CopperPilot/smartwatch/hardware/README.md

# Rugged 49 mm Smartwatch — Hardware & Electrical Design Documentation

Generated from `rea/spec.yaml` by `rea-hardware` (JLCPCB 2-layer stackup, 34.0 x 40.0 mm board outline at origin with 6.0 mm corner radius, and 4x M1.6 mounting holes), and completed with verified LCSC components, symbols, footprints, and 3D models.

## 1. Power Tree, Protection & Quiescent Current Budget

- **Rear Magnetic Pogo Charging Input (`J3`, `YZT0755-20028-02025-01`, LCSC `C5280828`, plus `TP9` on `/VCHG_RAW`):**
  - **Contact Current Rating:** Rated `2.0 A` per contact (`2 contacts` = `VCHG_RAW` and `GND`). Peak charging current is `147 mA` (`0.07x` rated current, `>13x` safety margin).
  - **ESD, Negative-Transient Clamping, Overcurrent PPTC Fuse, Reverse-Polarity Blocking, Overvoltage Protection & Reverse-Current Blocking:**
    - `D2` (`ESDLC12VLB`, YANGJIE 12 V bidirectional ESD/surge protection TVS diode in DFN1006-2L, LCSC `C20168169`, `V_RWM = 12 V`, `V_BR = 14.0 V` min, `V_C = 20 V` at `I_PP = 6 A` `< 24 V`, connected between `/VCHG_RAW` and `/GND`) provides IEC 61000-4-2 +/-30 kV bidirectional ESD and surge clamping. Because `V_C <= 20 V`, negative ESD or reverse-polarity transients on `J3.1` are clamped to `>= -20 V` (well inside upstream P-MOSFET `Q7` `AO3401A` `V_DS(max) = -30 V` when `Q7` is off and `C24` holds `VCHG_IN` at `0 V`), while positive transients are clamped to `<= +20 V` so `U6.1` (`OVP_FB`, via `R27 = 35.7 kOhm` / `R28 = 10.0 kOhm`) never exceeds `20 V * 10.0 / 45.7 = 4.38 V` (strictly below `U6`'s `+6.0 V` FB Absolute Maximum Rating). `R26` (`100 kOhm`) bleeds `VCHG_RAW` to `0.00 V` when unmated so exterior gold-plated contacts never carry DC bias against skin.
    - `F2` (`0603L050SLYR`, Littelfuse `0.50 A` hold / `1.00 A` trip ultra-low-resistance `0.14 Ohm` typ / `0.35 Ohm` max 0603 PPTC resettable fuse, LCSC `C207014`) sits in series with `J3.1` between `/VCHG_RAW` (`F2.1`) and `/VCHG_FUSED` (`F2.2`), tripping at `<= 1.00 A` (`>3.4x` margin above the `147 mA` normal charge current and `< 52 mV` voltage drop at `147 mA`) to protect `D1` (`PMEG2010EA,115`, `1.0 A` max) and `U8` (`TPS2553DBVR`, `1.5 A` max).
    - `Q7` (`AO3401A`, P-MOSFET in SOT-23, LCSC `C15127`, `V_DS(max) = -30 V`, `V_GS(max) = +/-12 V`, `R_DS(on) ~ 50 mOhm`, drain `Q7.3` on `/VCHG_FUSED`, source `Q7.2` on `/VCHG_IN`, gate `Q7.1` on `/VCHG_Q7_G`) blocks reverse-polarity connections on `J3` before they can reach `U6`'s `-0.3 V` substrate limit. `Q7`'s gate is pulled to `GND` by `R38 = 100 kOhm` (`0402WGF1003TCE`, LCSC `C25741`, providing full `V_GS = -5 V` gate drive during normal 5 V charging and dissipating `< 4 mW` at 20 V clamping) and clamped across Source-to-Gate by `D11` (`PESD5V0S1BL`, LCSC `C2912556`).
    - `C24` (`GRM188R6YA106MA73D`, 10 uF 35 V X5R 0603, LCSC `C194427`) provides high-voltage input decoupling on `/VCHG_IN` per `ETA7014S2G` datasheet recommendations.
    - `U6` (`ETA7014S2G`, 36 V input overvoltage protection load switch in SOT-23-6, LCSC `C7465500`, `R_ON = 35 mOhm` typ) sits on `/VCHG_IN` (`U6.4`, with `VCC`/`EN` `U6.5`/`U6.2` filtered via `R29 = 1 kOhm` `0402WGF1001TCE`, LCSC `C11702` + `C23 = 1 uF` 50 V X5R 0402 `GRM155R61H105KE05D`, LCSC `C1518208`) and outputs `/VCHG_PROT` (`U6.3`, bypassed by `C26 = 1 uF` 25 V X5R 0402 `CL05A105KA5NQNC`, LCSC `C52923`). Precision `0.1%` thin-film divider `R27 = 35.7 kOhm` (`ERA-2AEB3572X`, LCSC `C2075580`) and `R28 = 10.0 kOhm` (`RT0402BRD0710KL`, LCSC `C190095`) on `OVP_FB` (`U6.1`, `V_FB = 1.26 V +/- 0.05 V` = `1.21 V` min to `1.31 V` max) programs the overvoltage cutoff threshold to `V_OVP(typ) = 1.26 V * (35.7 + 10.0) / 10.0 = 5.758 V`, with worst-case minimum `V_OVP(min) = 1.21 V * (35.7 * 0.999 + 10.0 * 1.001) / (10.0 * 1.001) = 5.521 V > 5.500 V` (guaranteeing normal `4.75–5.50 V` USB `vSafe5V` input never trips OVP) and worst-case maximum `V_OVP(max) = 1.31 V * (35.7 * 1.001 + 10.0 * 0.999) / (10.0 * 0.999) = 5.996 V < 6.000 V` (strictly below the `6.5 V` recommended operating and `7.0 V` Absolute Maximum Rating of downstream `U8` `TPS2553DBVR`, and below the `6.0 V` recommended operating and `7.0 V` Absolute Maximum Rating of `U2` `MCP73832T-2ACI/OT`), while `U6`'s internal soft-start controls capacitive hot-plug inrush into `C26` (`1 uF`) and `C11` (`4.7 uF`).
    - `U8` (`TPS2553DBVR`, TI `2.5–6.5 V` recommended operating / `7.0 V` Absolute Maximum Rating, `1.5 A`, `85 mOhm` current-limited power-distribution switch with active reverse input-output voltage blocking in SOT-23-6, LCSC `C55266`) sits downstream of `U6` between `/VCHG_PROT` (`IN` Pin 1, tied to `EN` Pin 3) and `/VBUS` (`OUT` Pin 6, decoupled by `C11 = 4.7 uF`), providing `504 mV` of recommended-operating margin (`6.500 V` vs `V_OVP(max) = 5.996 V`) and `1.004 V` of absolute-maximum margin (`7.000 V` vs `5.996 V`) across `U6`'s entire OVP tolerance window, active reverse-voltage/reverse-current blocking (`I_rev = 0.01 uA` typ / `1.0 uA` max when `V_OUT > V_IN + 135 mV`) so no battery voltage back-feeds onto `/VCHG_PROT` or exposed pogo contact `J3.1`, and `2 us` fast electronic current limiting programmed via `R41 = 35.7 kOhm` `0.1%` (`ERA-2AEB3572X`, LCSC `C2075580`) on `ILIM` (Pin 5, net `/VCHG_ILIM`) to `I_OS(min) = 667 mA`, `I_OS(typ) = 729 mA`, `I_OS(max) = 799 mA < 1.0 A`.
    - Factory charging test pad `TP9` (`B.Cu`) is connected to `/VCHG_RAW` upstream of `F2`, `Q7`, `U6`, and `U8` so factory fixture supplies pass through full overcurrent, reverse-polarity, OVP, soft-start, and RCB protection.
- **Battery Connector (`J2`, `SM02B-SRSS-TB(LF)(SN)`, LCSC `C160402`), 12 V PPTC Fuse (`F1`) & UVLO-Wakeable Reverse-Battery Protection (`Q2` + `Q6` + `Q8` + `D10` + `D13` + `D12` + `R34..R37`):**
  - Connector entry `/VBAT_IN` (`J2.1`) is protected directly at the connector by `D9` (`PESD5V0S1BL`, 5 V bidirectional TVS diode, LCSC `C2912556`) and series resettable PPTC fuse `F1` (`ASMD0603SL100-12V`, 12 V, `1.0 A` hold / `2.0 A` trip ultra-low-resistance `45 mOhm` typ 0603 PPTC fuse, LCSC `C48783158`).
  - High-side reverse-polarity P-MOSFET `Q2` (`AO3401A`, LCSC `C15127`, drain on `/VBAT_FUSED`, source on `/VBAT`) has its gate (`/VBAT_Q2_G`) pulled to its source (`/VBAT`) via `R34 = 1 MOhm` (`0402WGF1004TCE`, LCSC `C26083`) and pulled to `/GND` by N-MOSFET `Q6` (`BSS138K`, LCSC `C5224263`, `V_GS(th) = 0.4–1.0 V`), whose gate (`/VBAT_Q2_EN`) is driven from `/VBAT_FUSED` via `R35 = 100 kOhm` (`0402WGF1003TCE`, LCSC `C25741`) and from `/VBUS` via ultra-low-leakage diode `D10` (`1N4148WS`, LCSC `C2128`, net `/VBAT_WAKE`) in series with `R36 = 100 kOhm` (`0402WGF1003TCE`, LCSC `C25741`), while a second blocking diode `D13` (`1N4148WS`, LCSC `C2128`, net `/VBAT_SENSE_WAKE`) separately feeds `R37 = 100 kOhm` (`0402WGF1003TCE`, LCSC `C25741`), NPN BJT `Q8` (`MMBT3904`, LCSC `C909754`), and Schottky diode `D12` (`1N5819WS`, LCSC `C191023`) for reverse-polarity lockout without bleeding battery current (`0 uA` parasitic path from `VBAT_FUSED` through `R35 -> R36` when unplugged, preserving full `V_GS(Q6) = 3.0–4.2 V` gate drive).
- **1S LiPo Linear Charger (`U2`, `MCP73832T-2ACI/OT`, LCSC `C38066`) & Digital VBUS Detection (`R24`/`R25`):**
  - `R10 = 6.8 kOhm` (`C25917`) programs `I_REG = 1000 V / 6.8 kOhm = 147.1 mA` (`0.67C` for the `220 mAh` `LP352022` pouch cell).
  - Open-drain charge status output `U2.1` (`STAT`) is pulled up to `+3V3` via `R23` (`10 kOhm`) and routed to `U1.14` (`IO10`, `CHG_STAT`).
  - `/VBUS` presence is sensed digitally on `U1.15` (`GPIO11` / `RTC_GPIO11`) via `R24 = 68 kOhm` (`0402WGF6802TCE`, `C36871`) and `R25 = 100 kOhm` (`0402WGF1003TCE`, `C25741`), yielding `2.77–3.15 V > V_IH(min) = 2.475 V`.
- **Load-Sharing Power Path (`Q1` `AO3401A` + `D1` `PMEG2010EA,115` + `R13` `1 kOhm`), Buck-Boost +3V3 Regulation (`U4` `TPS63031DSKR` + `L1` `1.5 uH`) & LDO +1V8 Regulation (`U5` `ME6211C18M5G-N`):**
  - Low-leakage MEGA Schottky `D1` (`PMEG2010EA,115`, LCSC `C193668`) and P-MOSFET `Q1` (`AO3401A`, LCSC `C15127`, with `1 kOhm` gate pulldown `R13`) provide automatic single-diode-drop power path switching onto `/VSYS` (`10 uF` `C7`).
  - `U4` (`TPS63031DSKR`, LCSC `C15516`, `1.8–5.5 V` input, `3.3 V` fixed output buck-boost converter with `1.5 uH` inductor `L1` `WPN201610U1R5MT`, LCSC `C97017`, `EN` and `PS/SYNC` `U4.6`/`U4.7` tied to `VINA`/`VIN` on `/VSYS`, dedicated `100 nF` `C28` on `VINA` `U4.8`, `100 nF` `C3` adjacent to `U4.1` `VOUT`, and two parallel `10 uF` 25 V X5R 0603 bulk capacitors `C8` + `C27` `CL10A106MA8NRNC` `C96446` providing `>= 12 uF` DC-biased effective output capacitance) maintains regulated `+3V3` across the full `3.0–4.2 V` 1S LiPo discharge range, and `U5` (`ME6211C18M5G-N`, `C236671`, `1.8 V / 300 mA` LDO, `CE` tied to `VSYS`) supplies continuous `+1V8` to `U3` (`MAX30102EFD+T` `VDD`).
  - **Local IC Decoupling on `/+3V3`:** `C1` (`100 nF` 0402, `C1525`, at `8.29, 3.85 mm`) and `C13` (`10 uF` 0603, `C96446`, at `8.38, 5.85 mm`) are functionally grouped in the schematic and placed within `1.54–1.97 mm` of `U1` pin 3 (`3V3` pad at `10.02, 4.75 mm`) on `F.Cu` with dedicated local `/GND` stitching vias (`7.20, 3.85 mm` and `7.20, 6.625 mm`); `C4` (`100 nF` 0402, `C1525`, at `30.10, 23.45 mm`) is functionally grouped and placed immediately adjacent (`0.77 mm`) to `U9` (`TPS3421EGDRYR` at `31.25, 23.80 mm`) pin 4 (`VCC` pad at `30.86, 23.30 mm`) with a dedicated `/GND` stitching via at `(29.65, 23.65 mm)`.

## 2. Display Backlight Constant-Current Driver, UI Protection & Sensor Level Shifting

- **Display FPC (`J1`, `FPC-05FB-12PH20`, LCSC `C2856829`) & Constant-Current Backlight Driver (`U7`, `CAT4002ASD-GT3`, LCSC `C890382`):**
  - 12-pin 0.5 mm pitch double-sided contact FPC connector `J1` mates with the 12-pin 1.9-inch `170x320` `ST7789V2` IPS TFT module (`ZJY190S0800TG01` / `GMT169-01`), with `100 kOhm` pull-ups `R39`/`R40` on `LCD_CS`/`LCD_RES`, separate `LEDA` (Pin 3, tied to `/VSYS` with `1 uF` bypass `C25`), and `LEDK` (Pin 2, `/LCD_LEDK`) regulated by `U7` (`CAT4002ASD-GT3`, `R14 = 3.6 kOhm` for `41.7 mA` total sink current, dimmed via 1-wire EZDim pulse bursts on `U7.1` from `U1.25`).
- **Sealed-Enclosure Long-Press Push-Button Hardware Reset Supervisor (`U9`, `TPS3421EGDRYR`, LCSC `C2067262`):**
  - `U9` (`TPS3421EGDRYR`, `250 nA` push-button reset controller in SON-6, `TS` tied to `/GND` for `7.5 s` setup delay) monitors `SW2` (`/BTN_SIDE_SW`) and asserts a `400 ms` active-low hardware reset pulse on `/MCU_EN` (`U1.45`) when `SW2` is held for `>= 7.5 s`.
- **Rotary Encoder (`SW1`, `EC05E1220203`) & Tactile Button (`SW2`/`SW3`, `SKRTLAE010`) Contact-Current & ESD Protection:**
  - Switch terminals have `10 kOhm` pull-ups `R3..R6` to `+3V3` and 5 V bidirectional ESD TVS diodes `D5..D8` (`PESD5V0S1BL`, LCSC `C2912556`), followed by `10 kOhm` series current-limiting/ESD-isolation resistors `R30..R33` feeding `10 nF` encoder filter capacitors `C17..C18` (`<= 0.33 mA` contact discharge current) and `100 nF` tactile switch debounce capacitors `C19..C20`.
- **1.8 V <-> 3.3 V Fast-Mode I2C & Interrupt Level Translation (`Q3..Q5`, `BSS138K`, LCSC `C5224263`):**
  - `Q3`, `Q4`, and `Q5` use low-capacitance sub-1V-threshold small-signal N-MOSFETs (`BSS138K`, `C_iss = 25 pF`, `C_oss = 9.7 pF`, `C_rss = 2.2 pF`, `V_GS(th) = 0.4–1.0 V`) with gates on `+1V8`, `1.8 kOhm` pull-ups `R7, R8` (to `+1V8`) and `R20, R21` (to `+3V3`, `0402WGF1801TCE`, LCSC `C25871`) on `I2C_SCL` and `I2C_SDA` (yielding RC rise time `t_r ~ 70 ns << 300 ns` 400 kHz Fast-Mode limit while keeping total low-level sink current `I_OL = 2.83 mA < 3.0 mA`), and `10 kOhm` pull-ups `R9` (to `+1V8`) and `R22` (to `+3V3`, `0402WGF1002TCE`, LCSC `C25744`) on open-drain interrupt `HR_INT`.

## 3. Datasheet Derating Summary (Capacitors, MOSFETs, Connectors & Bootloader Path)

- **Capacitor Voltage Ratings (`>= 1.5x` Maximum Net Voltage):**
  - `/OVP_VCC` (`<= 20 V` surge clamped by `D2`): `C23` (`1 uF`, `GRM155R61H105KE05D`, `C1518208`) rated `50 V` (`2.50x` surge / `10.0x` nominal 5 V).
  - `/VCHG_IN` (`<= 20 V` surge clamped by `D2`): `C24` (`10 uF`, `GRM188R6YA106MA73D`, `C194427`) rated `35 V` (`1.75x` surge / `7.0x` nominal 5 V).
  - `/VCHG_PROT` (`<= 5.996 V` `U6` OVP cutoff): `C26` (`1 uF`, `CL05A105KA5NQNC`, `C52923`) rated `25 V` (`4.17x`).
  - `/VBUS` (`<= 5.996 V` OVP cutoff): `C11` (`4.7 uF`, `CL10A475KO8NNNC`, `C19666`) rated `16 V` (`2.67x`).
  - `/VBAT` (`<= 4.20 V` LiPo charge voltage): `C12` (`4.7 uF`, `CL10A475KO8NNNC`, `C19666`) rated `16 V` (`3.81x`).
  - `/VSYS` (`<= 5.8 V` OVP / `4.6 V` nominal): `C7, C14` (`10 uF`, `25 V`, `C96446`), `C25` (`1 uF`, `25 V`, `C52923`), and `C6, C28` (`100 nF`, `16 V`, `C1525`) provide `>= 2.76x` margin.
  - `/+3V3`, `/+1V8`, `/VBAT_ADC`, `/MCU_EN`, UI & RTC crystal nets (`<= 3.3 V`): `C1..C5, C15, C19, C20` (`16 V`), `C8, C9, C10, C13, C27` (`25 V`), and `C17, C18, C21, C22` (`50 V`) provide `>= 4.85x` margin.
- **MOSFET `|V_GS|` and `|V_DS|` Ratings:**
  - `Q7` (`AO3401A`, `V_DS(max) = -30 V`, `V_GS(max) = +/-12 V`): upstream `D2` (`ESDLC12VLB`, `V_C = 20 V` at `6 A`) clamps `|V_DS| <= 20 V < 30 V`, and `D11` (`PESD5V0S1BL` across Source-to-Gate) clamps `|V_GS| <= 7.0 V < 12 V`.
  - `Q1, Q2` (`AO3401A`, `V_DS(max) = -30 V`, `V_GS(max) = +/-12 V`): operate on `/VBUS` (`<= 6.0 V`) and `/VBAT` (`<= 4.2 V`), keeping `|V_GS| <= 6.0 V < 12 V` and `|V_DS| <= 6.0 V < 30 V`.
  - `Q3..Q6` (`BSS138K`, `V_DS(max) = 60 V`, `V_GS(max) = +/-20 V`): operate on `1.8 V`, `3.3 V`, and `4.2 V` nets (`|V_GS| <= 4.2 V < 20 V`).
- **Connector Contact Current Ratings & Ground Returns:**
  - `J3` (`YZT0755-20028-02025-01`, 2-pin pogo): rated `2.0 A`/contact vs `147 mA` charge current (`13.6x` margin).
  - `J2` (`SM02B-SRSS-TB(LF)(SN)`, 2-pin JST-SH): rated `1.0 A`/contact vs `<= 365 mA` peak battery current (`2.74x` margin).
  - `J1` (`FPC-05FB-12PH20`, 12-pin 0.5 mm FPC): rated `0.5 A`/contact vs `41.7 mA` on `LEDA`/`LEDK` and `< 15 mA` on `+3V3` `VDD`, with 4 distributed `GND` return pins (`Pins 1, 5, 6, 12`) flanking the backlight and 4-wire SPI signals.
- **MCU Programming & Bootloader Conditions (`U1`, `ESP32-S3-MINI-1-N8`):**
  - Native USB Serial/JTAG (`GPIO19` `USB_D-` / `GPIO20` `USB_D+` via `22 Ohm` `R15`/`R16` and `PESD5V0U1BL` `D3`/`D4`) and `UART0` (`U0TXD`/`U0RXD`), `MCU_EN` (`R1 = 10 kOhm` pull-up to `+3V3`, `C10 = 1 uF` delay, `TP6`), `GPIO0` (`BOOT_IO0`, `R2 = 10 kOhm` pull-up to `+3V3`, `TP5`), `+3V3` (`TP8`), `VCHG_RAW` (`TP9`), and `GND` (`TP7`) are exposed on `B.Cu` pogo test pads `TP1..TP9` (`GPIO45` and `GPIO46` strapping pins left unconnected at default internal pull-down).
