CopperPilot/smartwatch/reviews/judge.md

# Independent judge

A separate agent compares the renders of the finished design with the reference photos, without seeing the design files or the other agents' notes.

**Overall 8/10** · form 8 · features 9 · requirements 9 (pass mark 7).

## Differences from the reference

- The transverse band lug channels are cut into flat vertical top and bottom end walls rather than blending into angled underside lug chamfers as on the reference case.
- The active window of the off-the-shelf 1.9-inch 170x320 rectangular TFT panel leaves a slightly wider lateral black mask border under the cover glass than the reference custom squircle display.
- The rear sensor dome incorporates a dedicated 2-pin magnetic pogo contact cutout next to the central optical sensor window as specified for the magnetic pogo charging cable, and the left speaker grille uses an 8-hole two-row array adjacent to the action button rather than the reference 10-hole three-row pattern.

## Requirements

| Id | Verdict | Note |
|---|---|---|
| R1 | met | The 44.0 x 49.0 x 14.4 mm rounded-rectangular case combines an 11.4 mm lower titanium-style side wall and right-side crown guard with a stepped 3.0 mm domed rear sensor cover matching the reference silhouette. |
| R2 | met | Top and bottom 32.0 mm transverse T-slot lug channels in case_body accept the connector bars of the 49 mm corrugated tubular fluoroelastomer strap_band sliding sideways along +X. |
| R3 | met | Actuator and internal renders confirm crown_cap presses coaxially onto the horizontal shaft of rotary encoder SW1 (EC05E1220203) through a sealed side bore while snap-retained side_button and action_button plungers directly contact edge tactile switches SW2 and SW3 (SKRTLAE010). |
| R4 | met | Purchased 1.9-inch 170x320 ST7789V2 IPS TFT module (ZJY190S0800TG01) sits beneath a flat 40.4 x 45.4 x 1.0 mm cover glass with a printed black border bonded by 0.2 mm 3M 9495LE PSA onto a 1.5 mm case ledge inside a 1.75 mm raised bezel rim. |
| R5 | met | Bottom-mounted MAX30102EFD+T PPG optical sensor (U3) aligns concentrically behind the 12.0 mm circular optical sensor_window in the domed rear cover. |
| R6 | met | Port and rear renders confirm the 2-pin gold-plated magnetic spring pogo receptacle J3 (YZT0755-20028-02025-01) on the bottom of the PCB faces directly outward through the rear_cover stadium cutout with no extra side ports. |

## Features

| Id | Verdict | Note |
|---|---|---|
| F1 | ok | Flat cover glass with printed black perimeter border sits flush inside the thin 1.75 mm raised metal bezel rim over the 1.9-inch display window. |
| F2 | ok | Knurled rotary crown cap with orange accent ring sits in the upper right-side guard protrusion and mates coaxially onto the horizontal shaft of rotary encoder SW1. |
| F3 | ok | Pill-shaped right side button sits below the crown in the right-side guard housing and its internal plunger directly engages side tactile switch SW2. |
| F4 | ok | Flush pill-shaped orange action button sits on the left case wall next to the speaker grille and its internal plunger directly engages side tactile switch SW3. |
| F5 | ok | Circular 12.0 mm dark optical sensor window is centered in the domed rear cover directly over bottom-mounted PPG sensor U3. |
| F6 | ok | Both circular gold-plated pogo charging contacts of receptacle J3 face directly outward through the stadium cutout on the rear dome. |
