CopperPilot/smartwatch/reviews/review-main.md

# Design review: Main board

Datasheet-level review of the schematic and layout by CopperPilot's independent review agent (`validate`). Severity: **P0** must be fixed before fabrication, **P1** should be fixed, **P2** worth a look.

Result: **0 P0**, **0 P1**, **0 P2**.

No findings.
