CopperPilot/smartwatch/reference/README.md

# Reference

What the CopperPilot agents were given: the prompt in [prompt.md](prompt.md) and the photos below.

Reference photos of a commercial product, used here only for comparison. All rights belong to their owners; this project is not affiliated with or endorsed by the product's maker.

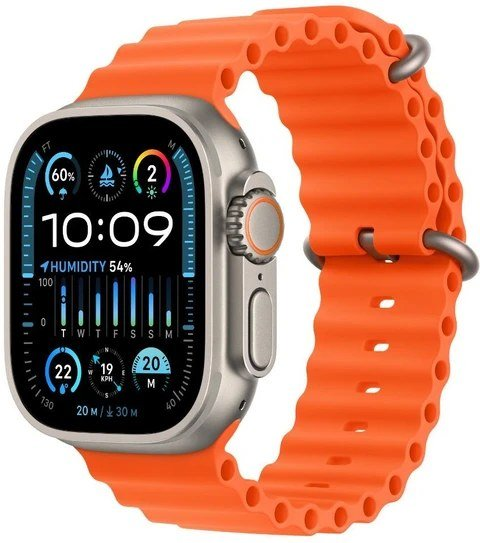
[picture p15: reference/photos/front.jpg]
front

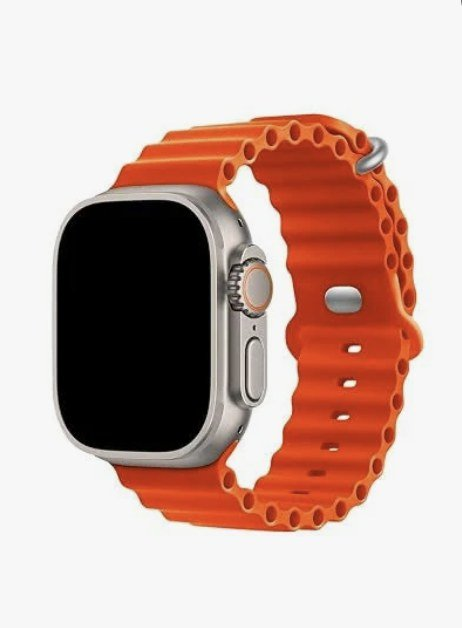
[picture p16: reference/photos/front_side.jpg]
front_side

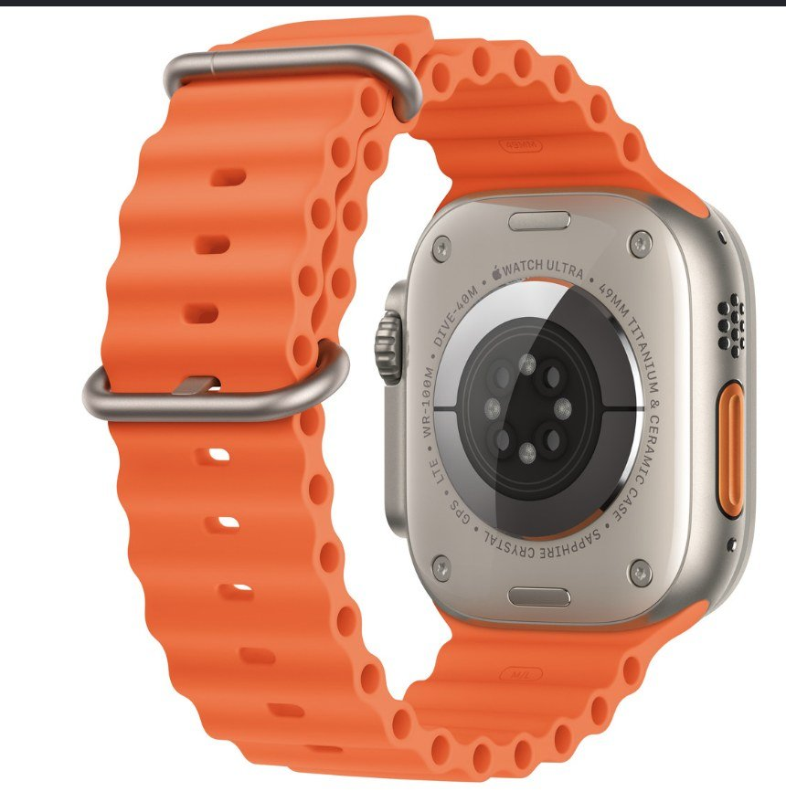
[picture p17: reference/photos/rear.jpg]
rear
