CopperPilot/smartwatch/docs/images/thumbnail.gif

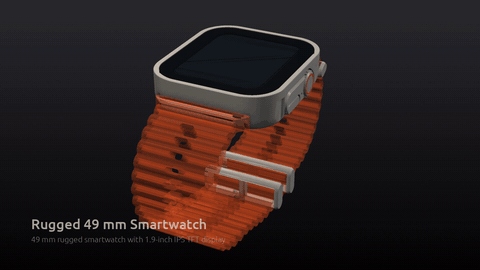
docs/images/thumbnail.gif
