CopperPilot/smartwatch/fab/rugged-smartwatch-bom.csv

Comment | Designator | Footprint | LCSC Part #
100nF | C1,C2,C3,C4,C5,C6,C15,C19,C20,C28 | C_0402_1005Metric | C1525
1uF | C9,C10,C25,C26 | C_0402_1005Metric | C52923
4.7uF | C11,C12,C16 | C_0603_1608Metric | C19666
10uF | C7,C8,C13,C14,C27 | C_0603_1608Metric | C96446
10nF | C17,C18 | C_0402_1005Metric | C60133
20pF | C21,C22 | C_0402_1005Metric | C1554
1uF | C23 | C_0402_1005Metric | C1518208
10uF | C24 | C_0603_1608Metric | C194427
PMEG2010EA,115 | D1 | SOD-323_L1.8-W1.3-LS2.5-RD | C193668
1N4148WS | D10,D13 | SOD-323_L1.8-W1.3-LS2.5-RD | C2128
PESD5V0S1BL | D5,D6,D7,D8,D9,D11 | DFN1006-2L-BI-1 | C2912556
1N5819WS | D12 | SOD-323_L1.8-W1.3-LS2.5-RD | C191023
ESDLC12VLB | D2 | DFN1006-2L-BI | C20168169
PESD5V0U1BL | D3,D4 | SOD-882_L1.0-W0.6-BI-1 | C2827663
ASMD0603SL100-12V | F1 | F0603 | C48783158
0603L050SLYR | F2 | F0603 | C207014
FPC-05FB-12PH20 | J1 | FPC-SMD_12P-P0.50_XUNPU_FPC-05FB-12PH20 | C2856829
SM02B-SRSS-TB(LF)(SN) | J2 | CONN-SMD_2P-P1.00_SM02B-SRSS-TB-LF-SN | C160402
YZT0755-20028-02025-01 | J3 | CONN-SMD_YZT0755-20028-02025-01 | C5280828
1.5uH | L1 | IND-SMD_L2.0-W1.6 | C97017
AO3401A | Q1,Q2,Q7 | SOT-23_L2.9-W1.3-P1.90-LS2.4-BR | C15127
BSS138K | Q3,Q4,Q5,Q6 | SOT-23-3_L2.9-W1.3-P1.90-LS2.4-BR | C5224263
MMBT3904 | Q8 | SOT-23-3_L2.9-W1.3-P1.90-LS2.4-BR | C909754
10k | R1,R2,R3,R4,R5,R6,R9,R22,R23,R30,R31,R32,R33 | R_0402_1005Metric | C25744
6.8k | R10 | R_0402_1005Metric | C25917
1M | R11,R12,R34 | R_0402_1005Metric | C26083
1k | R13,R29 | R_0402_1005Metric | C11702
3.6k | R14 | R_0402_1005Metric | C25891
22R | R15,R16 | R_0402_1005Metric | C25092
100k | R17,R25,R26,R35,R36,R37,R38,R39,R40 | R_0402_1005Metric | C25741
1.8k | R7,R8,R20,R21 | R_0402_1005Metric | C25871
68k | R24 | R_0402_1005Metric | C36871
35.7k | R27,R41 | R_0402_1005Metric | C2075580
10k | R28 | R_0402_1005Metric | C190095
EC05E1220203 | SW1 | SW-SMD_EC05E1220203 | C390930
SKRTLAE010 | SW2,SW3 | KEY-SMD_SKRTLAE010 | C110293
ESP32-S3-MINI-1-N8 | U1 | BULETM-SMD_ESP32-S3-MINI-1-N8 | C2913206
MCP73832T-2ACI/OT | U2 | SOT-23-5_L3.0-W1.7-P0.95-LS2.8-BL | C38066
MAX30102EFD+T | U3 | OESIP-14_L5.6-W3.3-P0.80-TL | C6454833
TPS63031DSKR | U4 | SON-10_L2.5-W2.5-P0.50-TL-EP | C15516
ME6211C18M5G-N | U5 | SOT-23-5_L3.0-W1.7-P0.95-LS2.8-BR | C236671
ETA7014S2G | U6 | SOT-23-6_L2.9-W1.6-P0.95-LS2.8-BL | C7465500
CAT4002ASD-GT3 | U7 | SC-70-6_L2.0-W1.3-P0.65-LS2.1-BR | C890382
TPS2553DBVR | U8 | SOT-23-6_L2.9-W1.6-P0.95-LS2.8-BR | C55266
TPS3421EGDRYR | U9 | SON-6_L1.5-W1.0-P0.50-BL | C2067262
32.768kHz | Y1 | FC-135R_L3.2-W1.5 | C32346
