CopperPilot/smartwatch/case/out/sensor_window_decor.stl

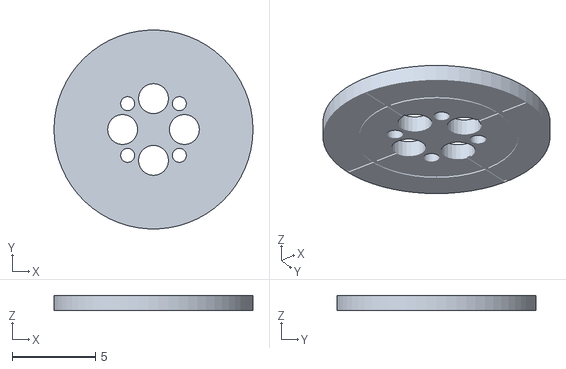
[picture p19: CAD file, 2026-11-04]
case/out/sensor_window_decor.stl
11.9 x 11.9 x 0.88
