CopperPilot/smartwatch/fab/mech/case_body.step

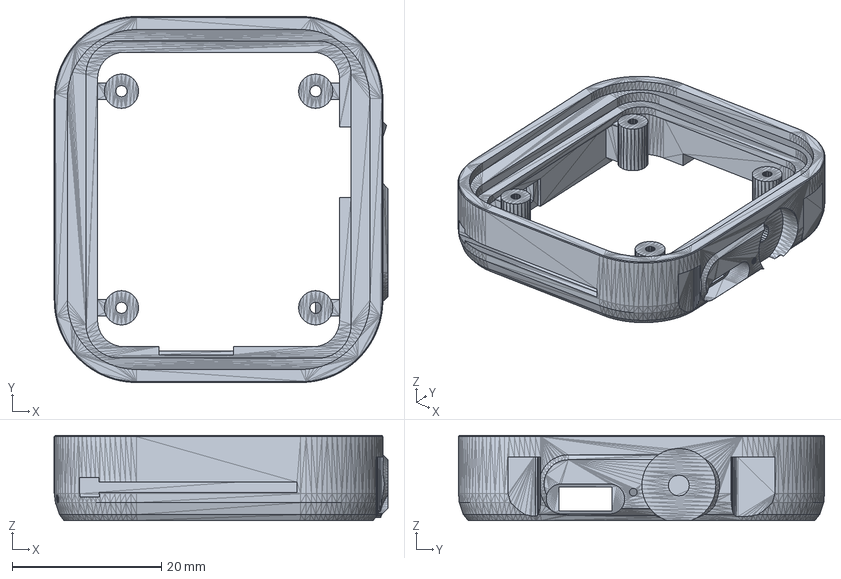
[picture p20: CAD file, 2026-11-04]
fab/mech/case_body.step
44.7 x 49.0 x 11.4 mm
