CopperPilot/smartwatch/fab/rugged-smartwatch.step

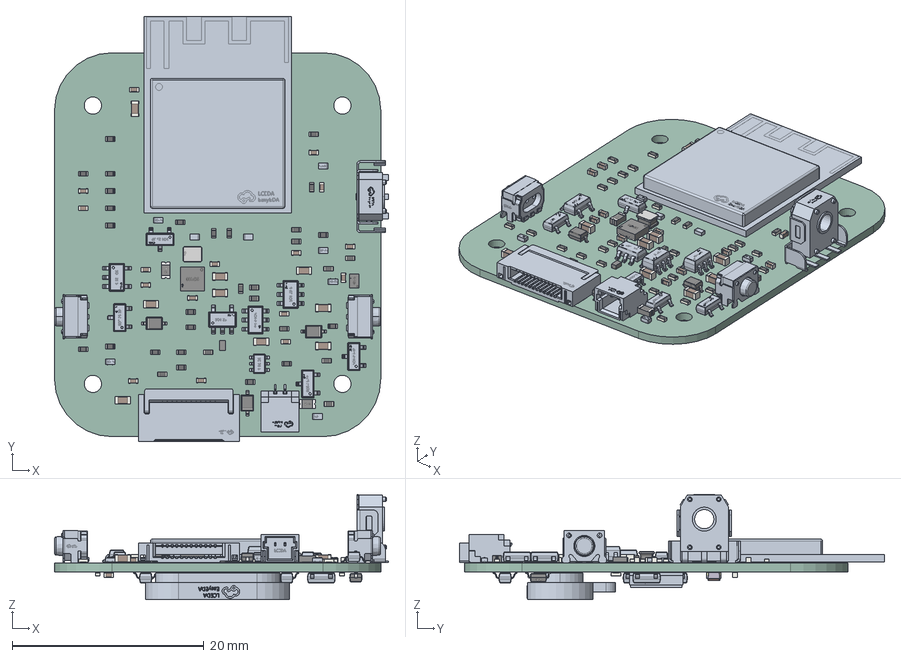
[picture p21: CAD file, 2026-11-04]
fab/rugged-smartwatch.step
34.8 x 44.3 x 11.0 mm
R_0402_1005Metric x 39
C_0603_1608Metric x 9
C_0402_1005Metric x 19
IND-SMD_L2.0-W1.6-H1.1
SON-10_L2.5-W2.5-H0.8-P0.50
零件2 x 4
F0603_L1.7-W0.9-H0.7 x 2
DFN1006-2L-BI
SON-6_L1.5-W1.0-H0.5-P0.50
FC-135R_L3.2-W1.5
rugged-smartwatch_PCB
