CopperPilot/smartwatch/fab/mech/sensor_window.step

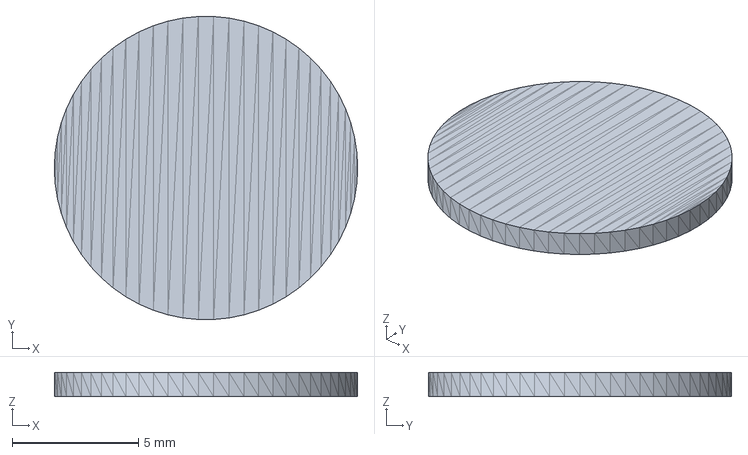
[picture p22: CAD file, 2026-11-04]
fab/mech/sensor_window.step
12.0 x 12.0 x 0.95 mm
