CopperPilot/smartwatch/case/out/crown_cap_decor.stl

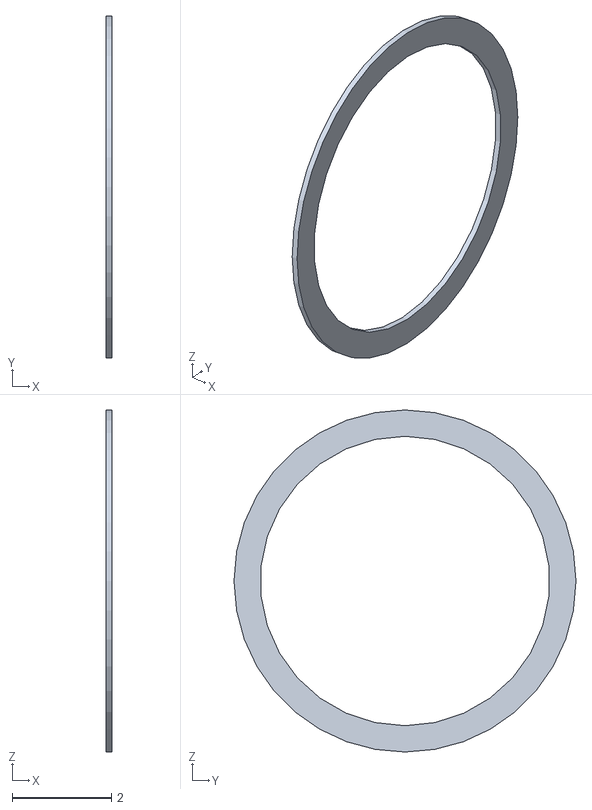
[picture p23: CAD file, 2026-11-04]
case/out/crown_cap_decor.stl
0.12 x 6.90 x 6.90
