CopperPilot/smartwatch/fab/mech/strap_band.stl

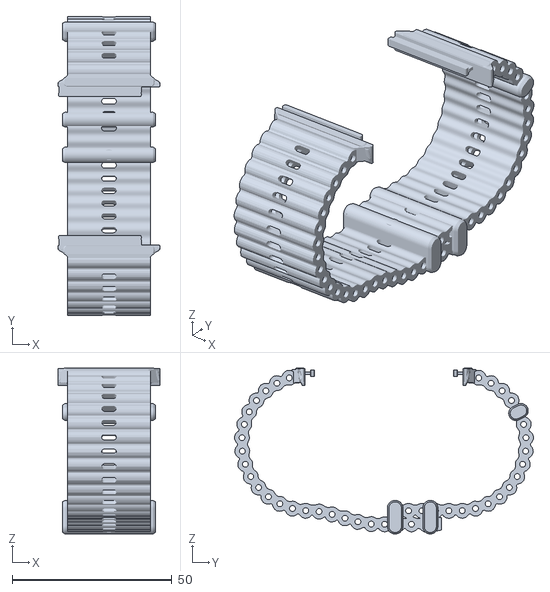
[picture p24: CAD file, 2026-11-04]
fab/mech/strap_band.stl
32.0 x 93.7 x 52.0
