CopperPilot/smartwatch/case/out/action_button.stl

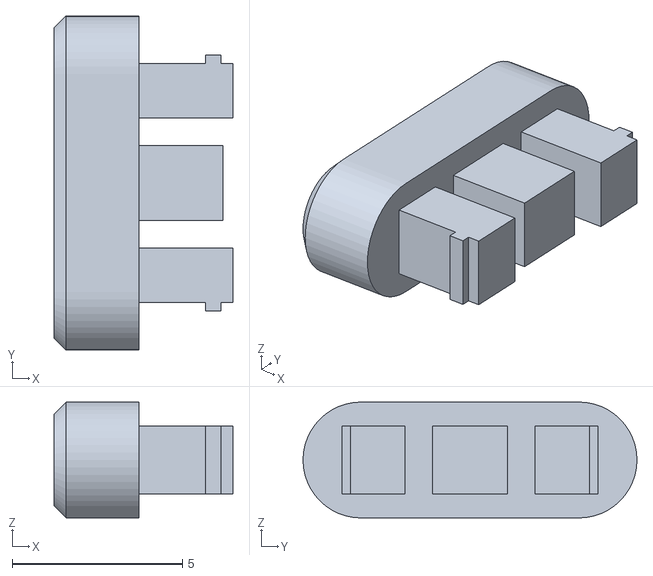
[picture p25: CAD file, 2026-11-04]
case/out/action_button.stl
5.25 x 9.80 x 3.40
