CopperPilot/smartwatch/fab/mech/cover_glass.step

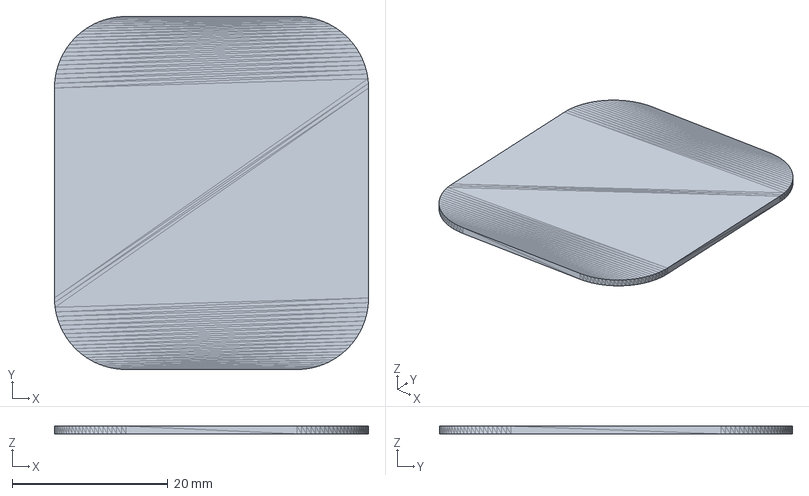
[picture p26: CAD file, 2026-11-04]
fab/mech/cover_glass.step
40.4 x 45.4 x 1.00 mm
