CopperPilot/smartwatch/fab/mech/rear_cover.stl

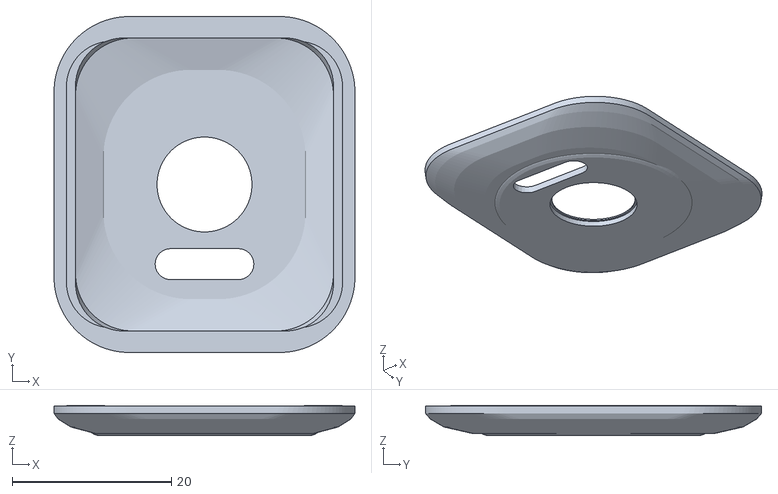
[picture p27: CAD file, 2026-11-04]
fab/mech/rear_cover.stl
37.8 x 42.2 x 3.78
