CopperPilot/smartwatch/case/out/cover_glass_decor.stl

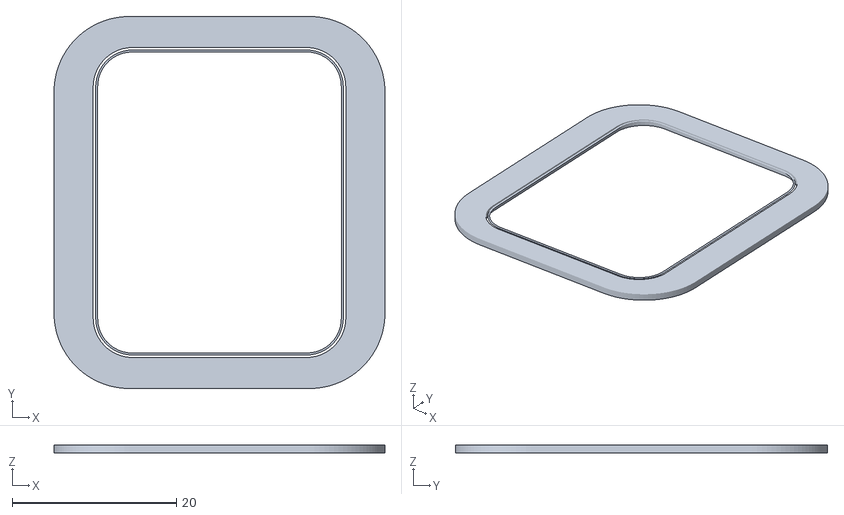
[picture p28: CAD file, 2026-11-04]
case/out/cover_glass_decor.stl
40.4 x 45.4 x 0.97
