CopperPilot/smartwatch/fab/mech/side_button.step

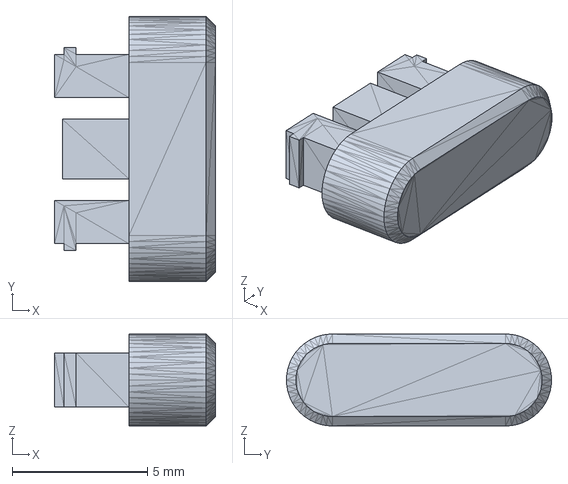
[picture p29: CAD file, 2026-11-04]
fab/mech/side_button.step
5.95 x 9.80 x 3.40 mm
