CopperPilot/smartwatch/fab/mech/crown_cap.step

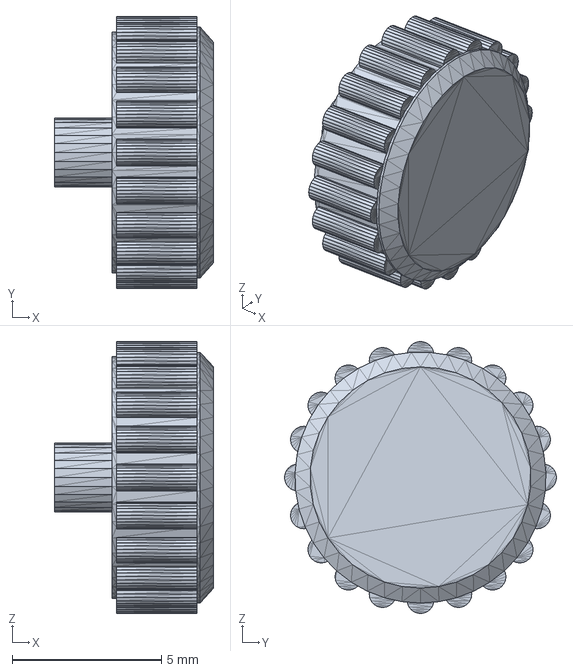
[picture p30: CAD file, 2026-11-04]
fab/mech/crown_cap.step
5.33 x 9.10 x 9.10 mm
