CopperPilot/smartwatch/case/out/strap_band_decor.stl

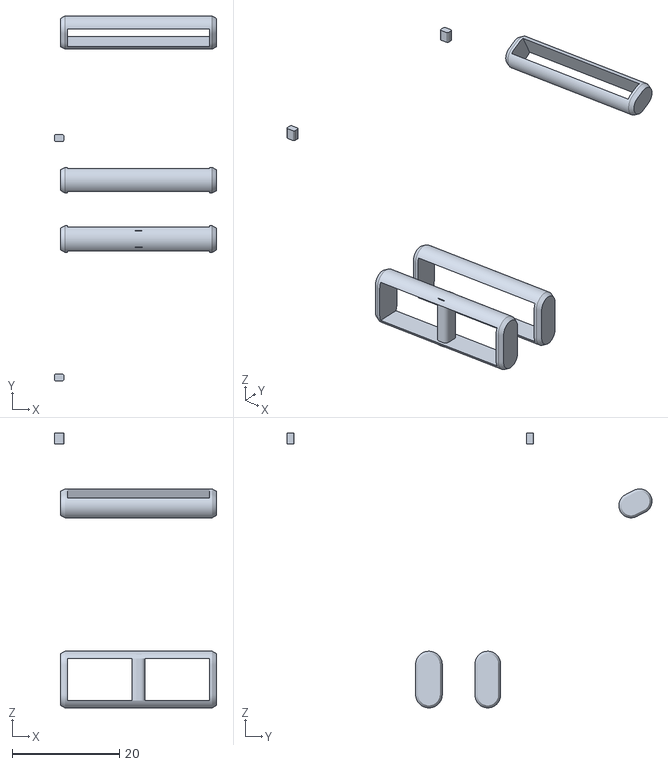
[picture p31: CAD file, 2026-11-04]
case/out/strap_band_decor.stl
30.4 x 68.2 x 51.4
