CopperPilot/smartwatch/case/out/rear_cover_decor.stl

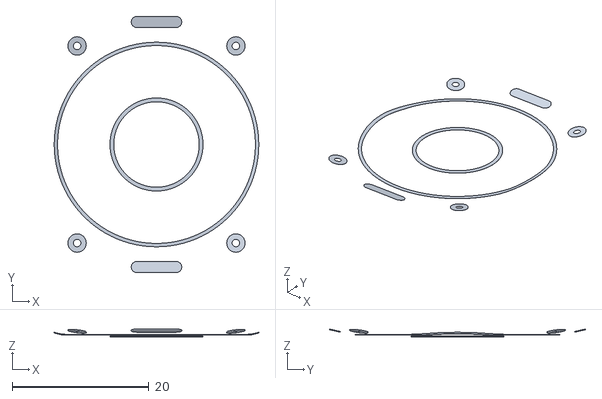
[picture p32: CAD file, 2026-11-04]
case/out/rear_cover_decor.stl
29.9 x 37.4 x 1.17
