CopperPilot/smartwatch/(list of files, cad)

Other CAD files:
case/out/case_body.stl
case/out/sensor_window.stl
case/out/side_button.stl
fab/mech/action_button.step
case/out/cover_glass.stl
case/out/crown_cap.stl
case/purchased/battery.stl
case/purchased/display_panel.stl
case/purchased/display_psa.stl
fab/mech/case_body.stl
fab/mech/cover_glass.stl
fab/mech/crown_cap.stl
fab/mech/sensor_window.stl
fab/mech/side_button.stl
