CopperPilot/smartwatch/fab/rugged-smartwatch-schematic.pdf

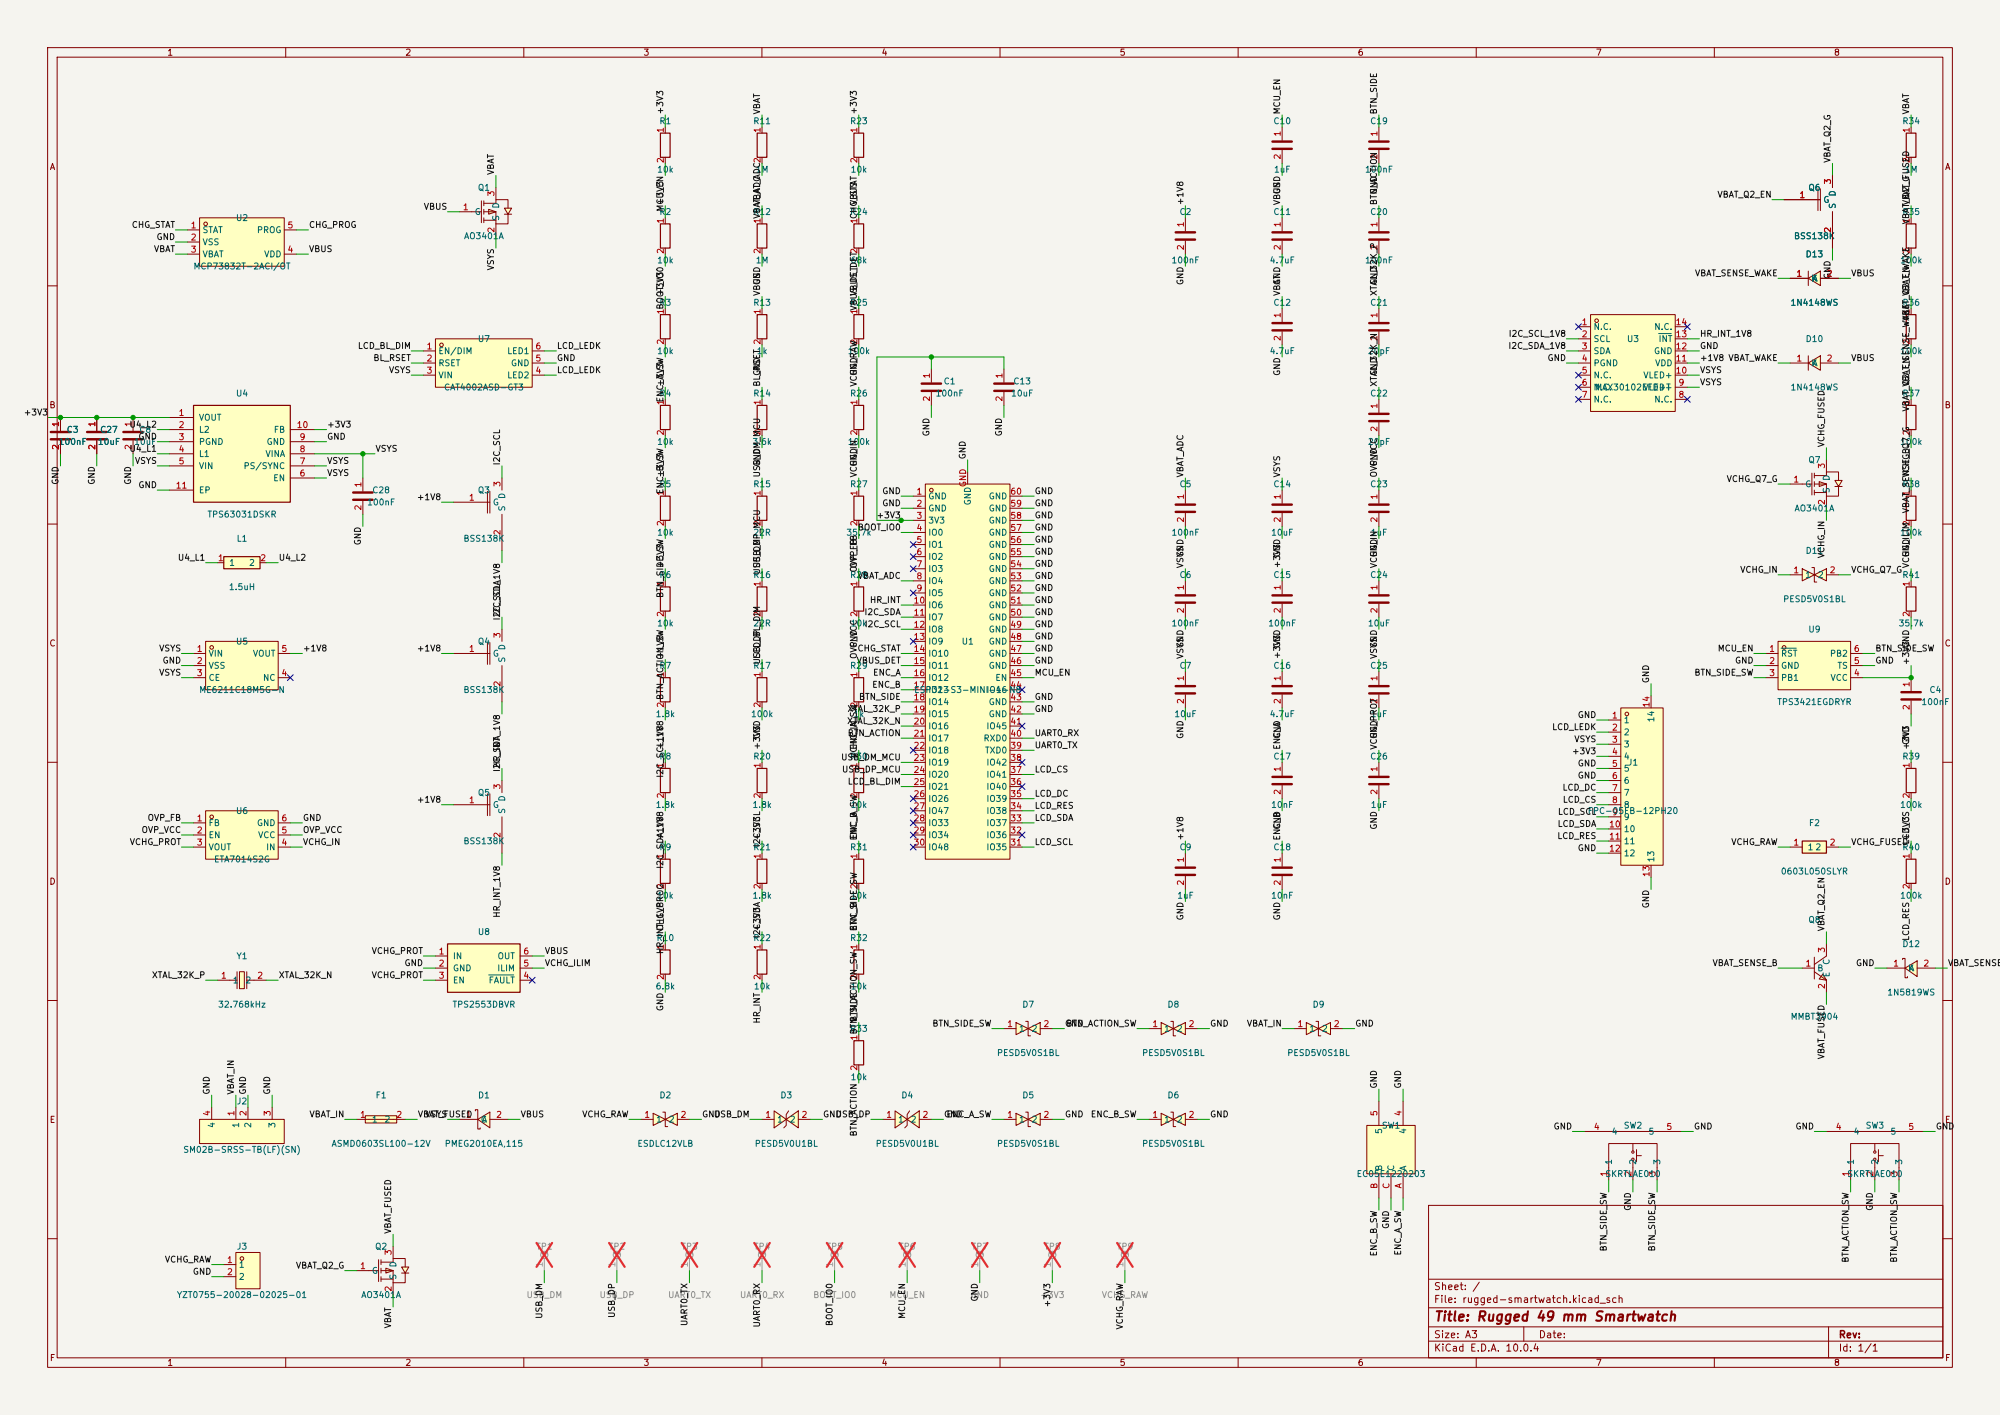
[picture p33: page 1]

VLED+ 10 VDD 11 GND 12 INT 13 N.C. 14 U3 MAX30102EFD+T 1 2 C6

SM02B-SRSS-TB(LF)(SN)

Sheet: /
File: rugged-smartwatch.kicad_sch
Title: Rugged 49 mm Smartwatch

Size: A3 | Rev: | F Date:
KiCad E.D.A. 10.0.4 | Id: 1/1
