CopperPilot/smartwatch/hardware/rugged-smartwatch.kicad_pcb

## KiCad design hardware/rugged-smartwatch.kicad_pcb (2026-11-04)

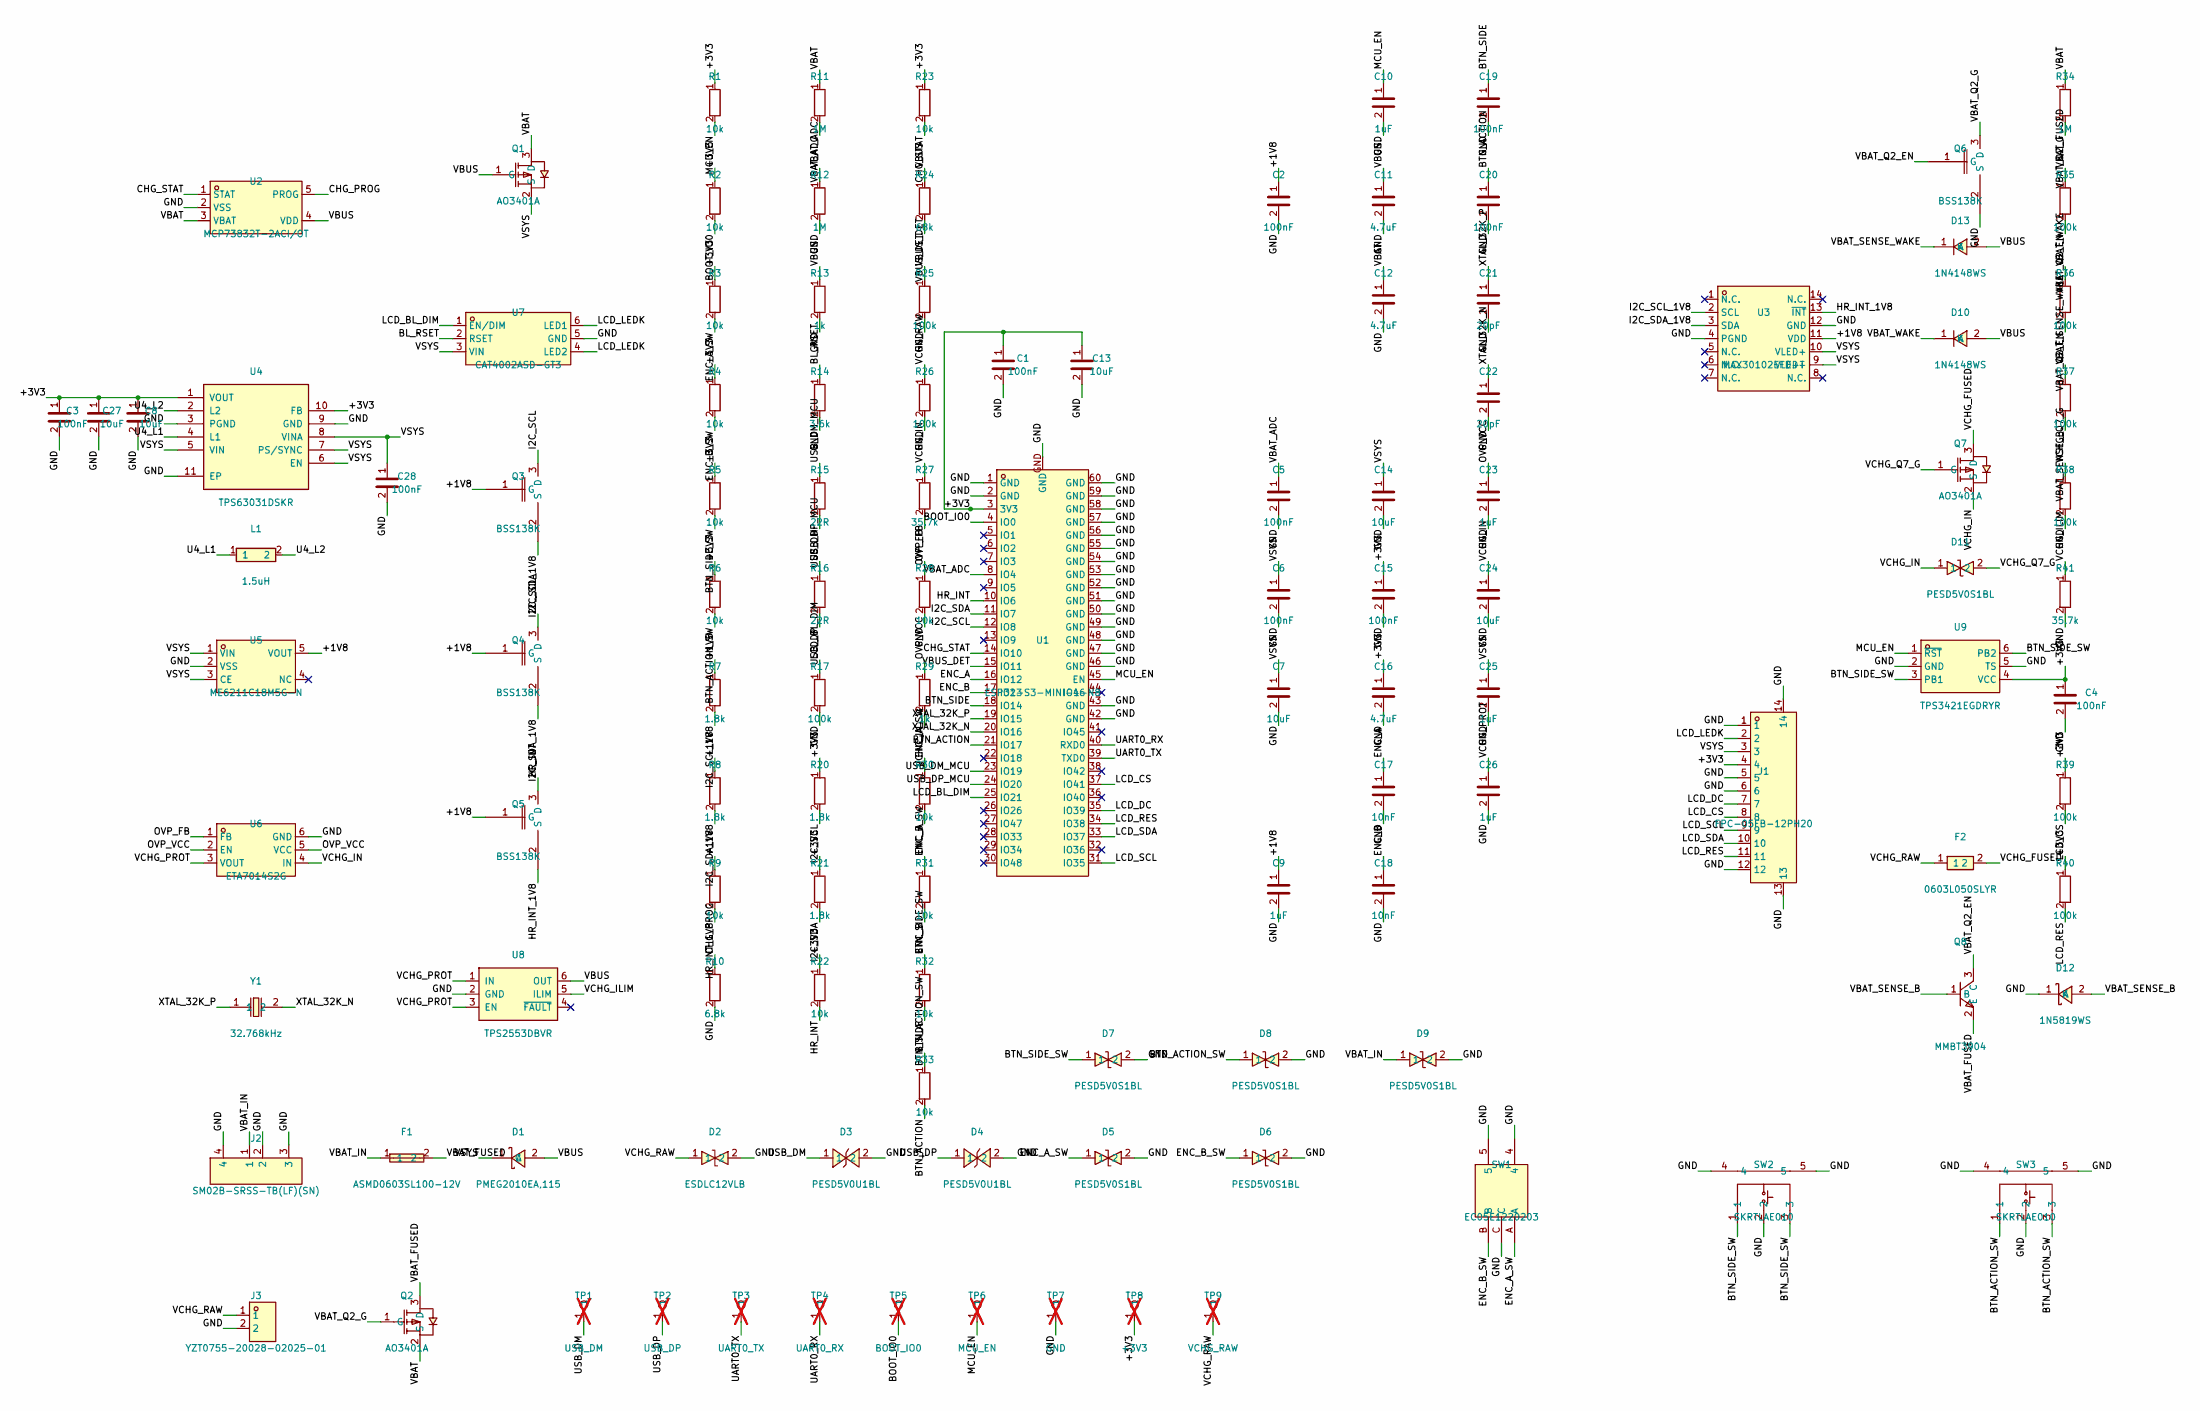
[picture p34: schematic rugged-smartwatch.kicad_sch, Rugged 49 mm Smartwatch]

Parts:
C1, C2, C3, C4, C5, C6, C15, C19, C20, C28: 100nF; C_0402_1005Metric; MPN CL05B104KO5NNNC; LCSC C1525
C7, C8, C13, C14, C27: 10uF; C_0603_1608Metric; MPN CL10A106MA8NRNC; LCSC C96446
C9, C10, C25, C26: 1uF; C_0402_1005Metric; MPN CL05A105KA5NQNC; LCSC C52923
C11, C12, C16: 4.7uF; C_0603_1608Metric; MPN CL10A475KO8NNNC; LCSC C19666
C17, C18: 10nF; C_0402_1005Metric; MPN CC0402KRX7R9BB103; LCSC C60133
C21, C22: 20pF; C_0402_1005Metric; MPN 0402CG200J500NT; LCSC C1554
C23: 1uF; C_0402_1005Metric; MPN GRM155R61H105KE05D; LCSC C1518208
C24: 10uF; C_0603_1608Metric; MPN GRM188R6YA106MA73D; LCSC C194427
D1: PMEG2010EA,115; SOD-323_L1.8-W1.3-LS2.5-RD; MPN PMEG2010EA,115; LCSC C193668
D2: ESDLC12VLB; DFN1006-2L-BI; MPN ESDLC12VLB; LCSC C20168169
D3, D4: PESD5V0U1BL; SOD-882_L1.0-W0.6-BI-1; MPN PESD5V0U1BL; LCSC C2827663
D5, D6, D7, D8, D9, D11: PESD5V0S1BL; DFN1006-2L-BI-1; MPN PESD5V0S1BL; LCSC C2912556
D10, D13: 1N4148WS; SOD-323_L1.8-W1.3-LS2.5-RD; MPN 1N4148WS; LCSC C2128
D12: 1N5819WS; SOD-323_L1.8-W1.3-LS2.5-RD; MPN 1N5819WS; LCSC C191023
F1: ASMD0603SL100-12V; F0603; MPN ASMD0603SL100-12V; LCSC C48783158
F2: 0603L050SLYR; F0603; MPN 0603L050SLYR; LCSC C207014
J1: FPC-05FB-12PH20; FPC-SMD_12P-P0.50_XUNPU_FPC-05FB-12PH20; MPN FPC-05FB-12PH20; LCSC C2856829
J2: SM02B-SRSS-TB(LF)(SN); CONN-SMD_2P-P1.00_SM02B-SRSS-TB-LF-SN; MPN SM02B-SRSS-TB(LF)(SN); LCSC C160402
J3: YZT0755-20028-02025-01; CONN-SMD_YZT0755-20028-02025-01; MPN YZT0755-20028-02025-01; LCSC C5280828
L1: 1.5uH; IND-SMD_L2.0-W1.6; MPN WPN201610U1R5MT; LCSC C97017
Q1, Q2, Q7: AO3401A; SOT-23_L2.9-W1.3-P1.90-LS2.4-BR; MPN AO3401A; LCSC C15127
Q3, Q4, Q5, Q6: BSS138K; SOT-23-3_L2.9-W1.3-P1.90-LS2.4-BR; MPN BSS138K; LCSC C5224263
Q8: MMBT3904; SOT-23-3_L2.9-W1.3-P1.90-LS2.4-BR; MPN MMBT3904; LCSC C909754
R1, R2, R3, R4, R5, R6, R9, R22, R23, R30, R31, R32, R33: 10k; R_0402_1005Metric; MPN 0402WGF1002TCE; LCSC C25744
R7, R8, R20, R21: 1.8k; R_0402_1005Metric; MPN 0402WGF1801TCE; LCSC C25871
R10: 6.8k; R_0402_1005Metric; MPN 0402WGF6801TCE; LCSC C25917
R11, R12, R34: 1M; R_0402_1005Metric; MPN 0402WGF1004TCE; LCSC C26083
R13, R29: 1k; R_0402_1005Metric; MPN 0402WGF1001TCE; LCSC C11702
R14: 3.6k; R_0402_1005Metric; MPN 0402WGF3601TCE; LCSC C25891
R15, R16: 22R; R_0402_1005Metric; MPN 0402WGF220JTCE; LCSC C25092
R17, R25, R26, R35, R36, R37, R38, R39, R40: 100k; R_0402_1005Metric; MPN 0402WGF1003TCE; LCSC C25741
R24: 68k; R_0402_1005Metric; MPN 0402WGF6802TCE; LCSC C36871
R27, R41: 35.7k; R_0402_1005Metric; MPN ERA-2AEB3572X; LCSC C2075580
R28: 10k; R_0402_1005Metric; MPN RT0402BRD0710KL; LCSC C190095
SW1: EC05E1220203; SW-SMD_EC05E1220203; MPN EC05E1220203; LCSC C390930
SW2, SW3: SKRTLAE010; KEY-SMD_SKRTLAE010; MPN SKRTLAE010; LCSC C110293
TP1: USB_DM; TestPoint_Pad_D1.0mm; not fitted
TP2: USB_DP; TestPoint_Pad_D1.0mm; not fitted
TP3: UART0_TX; TestPoint_Pad_D1.0mm; not fitted
TP4: UART0_RX; TestPoint_Pad_D1.0mm; not fitted
TP5: BOOT_IO0; TestPoint_Pad_D1.0mm; not fitted
TP6: MCU_EN; TestPoint_Pad_D1.0mm; not fitted
TP7: GND; TestPoint_Pad_D1.0mm; not fitted
TP8: +3V3; TestPoint_Pad_D1.0mm; not fitted
TP9: VCHG_RAW; TestPoint_Pad_D1.0mm; not fitted
U1: ESP32-S3-MINI-1-N8; BULETM-SMD_ESP32-S3-MINI-1-N8; MPN ESP32-S3-MINI-1-N8; LCSC C2913206
U2: MCP73832T-2ACI/OT; SOT-23-5_L3.0-W1.7-P0.95-LS2.8-BL; MPN MCP73832T-2ACI/OT; LCSC C38066
U3: MAX30102EFD+T; OESIP-14_L5.6-W3.3-P0.80-TL; MPN MAX30102EFD+T; LCSC C6454833
U4: TPS63031DSKR; SON-10_L2.5-W2.5-P0.50-TL-EP; MPN TPS63031DSKR; LCSC C15516
U5: ME6211C18M5G-N; SOT-23-5_L3.0-W1.7-P0.95-LS2.8-BR; MPN ME6211C18M5G-N; LCSC C236671
U6: ETA7014S2G; SOT-23-6_L2.9-W1.6-P0.95-LS2.8-BL; MPN ETA7014S2G; LCSC C7465500
U7: CAT4002ASD-GT3; SC-70-6_L2.0-W1.3-P0.65-LS2.1-BR; MPN CAT4002ASD-GT3; LCSC C890382
U8: TPS2553DBVR; SOT-23-6_L2.9-W1.6-P0.95-LS2.8-BR; MPN TPS2553DBVR; LCSC C55266
U9: TPS3421EGDRYR; SON-6_L1.5-W1.0-P0.50-BL; MPN TPS3421EGDRYR; LCSC C2067262
Y1: 32.768kHz; FC-135R_L3.2-W1.5; MPN Q13FC13500004; LCSC C32346

Connections:
/+1V8: C2.1, C9.1, Q3.1 (G), Q4.1 (G), Q5.1 (G), R7.1, R8.1, R9.1, U3.11 (VDD), U5.5 (VOUT)
/+3V3: C1.1, C3.1, C4.1, C8.1, C13.1, C15.1, C16.1, C27.1, J1.4, R1.1, R2.1, R3.1, R4.1, R5.1, R6.1, R20.1, R21.1, R22.1, R23.1, R39.1, R40.1, TP8.1, U1.3 (3V3), U4.1 (VOUT), U4.10 (FB), U9.4 (VCC)
/BL_RSET: R14.1, U7.2 (RSET)
/BOOT_IO0: R2.2, TP5.1, U1.4 (IO0)
/BTN_ACTION: C20.1, R33.2, U1.21 (IO17)
/BTN_ACTION_SW: D8.1, R6.2, R33.1, SW3.1, SW3.3
/BTN_SIDE: C19.1, R32.2, U1.18 (IO14)
/BTN_SIDE_SW: D7.1, R5.2, R32.1, SW2.1, SW2.3, U9.3 (PB1), U9.6 (PB2)
/CHG_PROG: R10.1, U2.5 (PROG)
/CHG_STAT: R23.2, U1.14 (IO10), U2.1 (STAT)
/ENC_A: C17.1, R30.2, U1.16 (IO12)
/ENC_A_SW: D5.1, R3.2, R30.1, SW1.A
/ENC_B: C18.1, R31.2, U1.17 (IO13)
/ENC_B_SW: D6.1, R4.2, R31.1, SW1.B
/GND: C1.2, C2.2, C3.2, C4.2, C5.2, C6.2, C7.2, C8.2, C9.2, C10.2, C11.2, C12.2, C13.2, C14.2, C15.2, C16.2, C17.2, C18.2, C19.2, C20.2, C21.2, C22.2, C23.2, C24.2, C25.2, C26.2, C27.2, C28.2, D2.2, D3.2, D4.2, D5.2, D6.2, D7.2, D8.2, D9.2, D12.1 (K), J1.1, J1.5, J1.6, J1.12, J1.13, J1.14, J2.2, J2.3, J2.4, J3.2, Q6.2 (S), R10.2, R12.2, R13.2, R14.2, R17.2, R25.2, R26.2, R28.2, R38.2, R41.2, SW1.4, SW1.5, SW1.C, SW2.2, SW2.4, SW2.5, SW3.2, SW3.4, SW3.5, TP7.1, U1.1 (GND), U1.2 (GND), U1.42 (GND), U1.43 (GND), U1.46 (GND), U1.47 (GND), U1.48 (GND), U1.49 (GND), U1.50 (GND), U1.51 (GND), U1.52 (GND), U1.53 (GND), U1.54 (GND), U1.55 (GND), U1.56 (GND), U1.57 (GND), U1.58 (GND), U1.59 (GND), U1.60 (GND), U1.GND, U2.2 (VSS), U3.4 (PGND), U3.12 (GND), U4.3 (PGND), U4.9 (GND), U4.11 (EP), U5.2 (VSS), U6.6 (GND), U7.5 (GND), U8.2 (GND), U9.2 (GND), U9.5 (TS)
/HR_INT: Q5.3 (D), R22.2, U1.10 (IO6)
/HR_INT_1V8: Q5.2 (S), R9.2, U3.13 (~INT)
/I2C_SCL: Q3.3 (D), R20.2, U1.12 (IO8)
/I2C_SCL_1V8: Q3.2 (S), R7.2, U3.2 (SCL)
/I2C_SDA: Q4.3 (D), R21.2, U1.11 (IO7)
/I2C_SDA_1V8: Q4.2 (S), R8.2, U3.3 (SDA)
/LCD_BL_DIM: R17.1, U1.25 (IO21), U7.1 (EN/DIM)
/LCD_CS: J1.8, R39.2, U1.37 (IO41)
/LCD_DC: J1.7, U1.35 (IO39)
/LCD_LEDK: J1.2, U7.4 (LED2), U7.6 (LED1)
/LCD_RES: J1.11, R40.2, U1.34 (IO38)
/LCD_SCL: J1.9, U1.31 (IO35)
/LCD_SDA: J1.10, U1.33 (IO37)
/MCU_EN: C10.1, R1.2, TP6.1, U1.45 (EN), U9.1 (~RST)
/OVP_FB: R27.2, R28.1, U6.1 (FB)
/OVP_VCC: C23.1, R29.1, U6.2 (EN), U6.5 (VCC)
/U4_L1: L1.1, U4.4 (L1)
/U4_L2: L1.2, U4.2 (L2)
/UART0_RX: TP4.1, U1.40 (RXD0)
/UART0_TX: TP3.1, U1.39 (TXD0)
/USB_DM: D3.1, R15.2, TP1.1
/USB_DM_MCU: R15.1, U1.23 (IO19)
/USB_DP: D4.1, R16.2, TP2.1
/USB_DP_MCU: R16.1, U1.24 (IO20)
/VBAT: C12.1, Q1.3 (D), Q2.2 (S), R11.1, R34.1, U2.3 (VBAT)
/VBAT_ADC: C5.1, R11.2, R12.1, U1.8 (IO4)
/VBAT_FUSED: F1.2, Q2.3 (D), Q8.2 (E), R35.1
/VBAT_IN: D9.1, F1.1, J2.1
/VBAT_Q2_EN: Q6.1 (G), Q8.3 (C), R35.2, R36.2
/VBAT_Q2_G: Q2.1 (G), Q6.3 (D), R34.2
/VBAT_SENSE_B: D12.2 (A), Q8.1 (B), R37.2
/VBAT_SENSE_WAKE: D13.1 (K), R37.1
/VBAT_WAKE: D10.1 (K), R36.1
/VBUS: C11.1, D1.2 (A), D10.2 (A), D13.2 (A), Q1.1 (G), R13.1, R24.1, U2.4 (VDD), U8.6 (OUT)
/VBUS_DET: R24.2, R25.1, U1.15 (IO11)
/VCHG_FUSED: F2.2, Q7.3 (D)
/VCHG_ILIM: R41.1, U8.5 (ILIM)
/VCHG_IN: C24.1, D11.1, Q7.2 (S), R27.1, R29.2, U6.4 (IN)
/VCHG_PROT: C26.1, U6.3 (VOUT), U8.1 (IN), U8.3 (EN)
/VCHG_Q7_G: D11.2, Q7.1 (G), R38.1
/VCHG_RAW: D2.1, F2.1, J3.1, R26.1, TP9.1
/VSYS: C6.1, C7.1, C14.1, C25.1, C28.1, D1.1 (C), J1.3, Q1.2 (S), U3.9 (VLED+), U3.10 (VLED+), U4.5 (VIN), U4.6 (EN), U4.7 (PS/SYNC), U4.8 (VINA), U5.1 (VIN), U5.3 (CE), U7.3 (VIN)
/XTAL_32K_N: C22.1, U1.20 (IO16), Y1.2
/XTAL_32K_P: C21.1, U1.19 (IO15), Y1.1

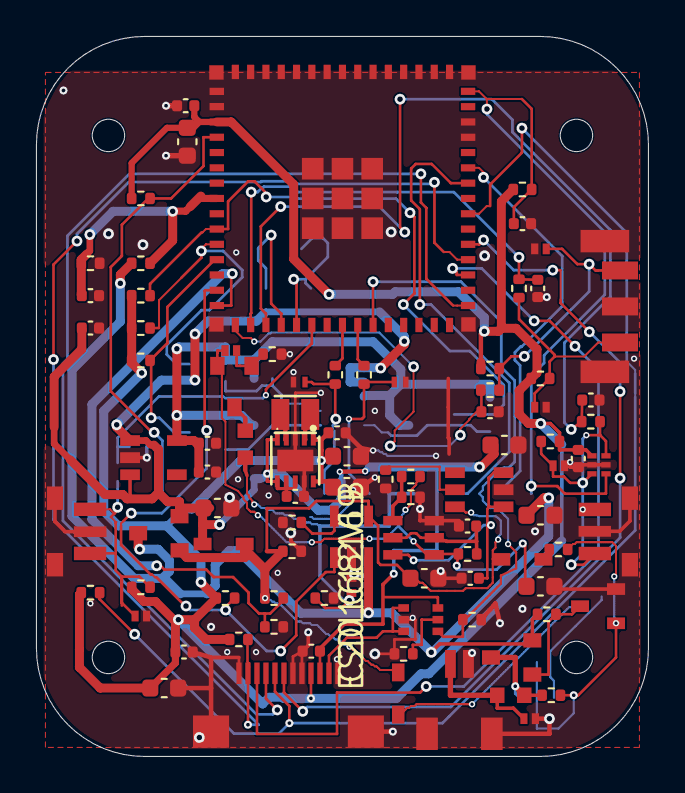
[picture p35: board rugged-smartwatch.kicad_pcb from above]

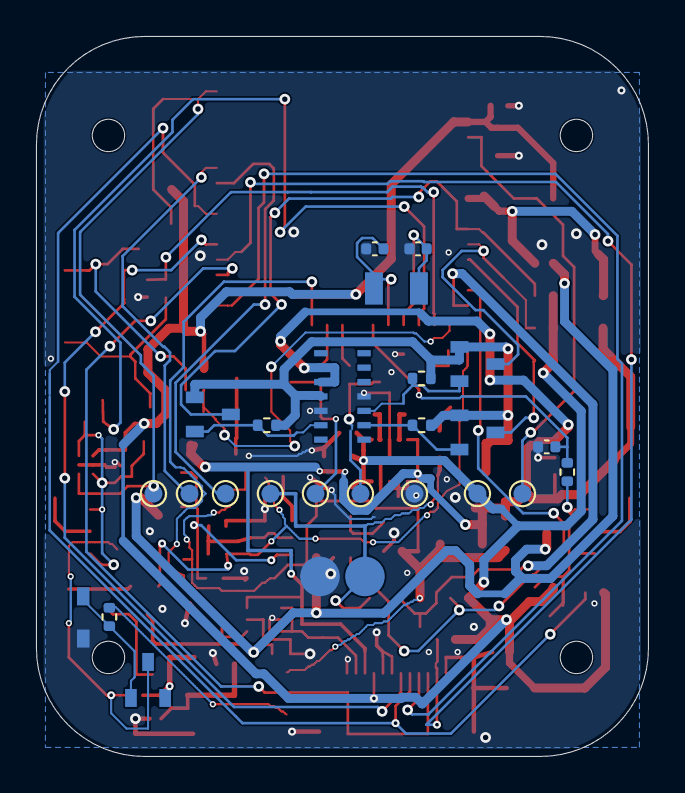
[picture p36: board rugged-smartwatch.kicad_pcb from below]

Board: 2 copper layers, 34.0 x 40.0 mm, 120 parts (25 on the bottom side), 59 nets.

Other parts of the board:
H1, H2, H3, H4: MountingHole; MountingHole_1.8mm
