CopperPilot/smartwatch/(commit log)

2026-11-04 CopperPilot Rugged Smartwatch: design files, reviews and build film
    [action_button.step, action_button.stl, battery.stl, case_body.step, case_body.stl, cover_glass.step, cover_glass.stl, cover_glass_decor.stl]
2026-11-08 Build film and renders re-rendered: parts back out along their assembly direction, checked frame by frame
    The exploded view now moves every part opposite the direction it was fitted, so nothing passes through
    anything (the rear shell used to fly up through the stack). Every frame is replayed against the 3D models
    and a separate critic watches the film (reviews/film.md).
2026-11-08 Film review from a critic that saw only this film's frames
